RedWaltz-Moon/xiaoya-fpga-airwriting/技术复盘.md

# 空中书写学习系统：技术复盘

本文整理项目中可复用的设计经验与验证边界，状态截至2026年10月26日。部署、接线、编译和日常操作以各目录README为准。

## 文档分工

| 内容 | 入口 |
| --- | --- |
| 项目架构、目录与快速开始 | [项目README](README.md) |
| FPGA引脚、板端操作、灯环、音频、打印和时序限制 | [FPGA工程README](acg720_dvp_ov5640_hdmi/README.md) |
| 香橙派部署、课程、档案、小票与扩展协议 | [学习应用README](orange_pi_game/README.md) |
| 样本来源与划分 | [数据README](data/README.md) |
| 模型类型、训练方法与验证结果 | [模型README](models/README.md) |
| 采集、训练、推理与UART排错 | [工具README](tools/README.md) |

正式工程的顶层和输出基名均为 `acg720_dvp_ov5640_hdmi`。

## 系统分工的取舍

FPGA承担摄像头采集、目标检测、指尖与轨迹处理、64点重采样和串口传输；香橙派承担字符分类、学习交互、档案和小票排版。FPGA HDMI独立显示摄像头与调试画面，香橙派 HDMI显示学习应用。两端传递确认后的轨迹与字符事件，无需传输实时视频。

这一分工使视觉处理和学习界面可以分别排错。模型、词库或页面调整通常只影响香橙派；摄像头、检测与轨迹问题在FPGA端定位。当前模型是本地NumPy最近模板分类器，运行不以YOLO、神经网络或NPU部署为前提。

| 早期方案或现象 | 最终采用的方式 | 原因 |
| --- | --- | --- |
| 用整帧红色面积和总包围框判断目标 | 使用空间候选，分别检查面积、形状和位置关系 | 减少分散噪点或远处色块共同拉大检测框 |
| 将最高轮廓点直接当作指尖 | 在合格手部候选中结合单指形态与连续帧状态 | 张掌和握拳都可能出现局部突起，最高点不足以证明正在书写 |
| 直接将每次识别结果视作新的输入 | 一次确认轨迹对应一次应用字符事件 | 避免重复包、线程积压或长时间保持姿势造成重复计分 |
| 为相似大小写强行修改模型输出 | 保留62类预测，在应用判分层限定等价组 | 区分模型评估、FPGA回显与课程容错 |
| 由FPGA组织学习小票正文 | 香橙派完成记录选择、日期与GBK排版，FPGA转发 | FPGA无需理解课程、成绩或词汇内容 |

## FPGA视觉与轨迹处理

### 颜色入口与目标筛选

PEN使用红笔，HAND使用绿色手套；当前方案不要求背景布。光照、同色目标、轮廓完整度和摄像头极边缘漂白仍会影响检测，取消背景布条件并不意味着任意环境下都能稳定识别。

噪点问题不能只靠降低颜色门限解决。门限放宽会同时引入背景像素，形成桥接、拉长包围框，并影响位置估计。空间去噪、单候选面积和形态筛选应各自承担明确职责；显示mask中仍可能看到小噪点，但它们不应自动获得跟踪或书写资格。

HAND的8槽候选属于有限资源下的空间筛选，并非完整连通域合并。跟踪、断段和手势判定需要保留失配状态：短暂丢失时不能把不可信坐标接入轨迹，重新捕获也不能直接连向旧位置。单食指书写、比耶确认和五指张开清空是不同输入状态，不能用同一套最高点条件代替。

### 确认快照与状态边界

公共缓存最多保存256个采样点。确认后冻结当前轨迹，经有效性检查、等弧长64点重采样和保比例归一化，输出 `64×2 uint8` 坐标。确认、发送、等待回传和清空分别有明确的状态边界：

- 无效短轨迹不发送，也不产生假WAIT；确认后的缓存仍须清空才能重新书写。
- 有效轨迹整帧发完进入WAIT，合法同序号字符回传后进入DONE。
- 重复确认不能重新发送或擦掉已有结果；HAND确认后不能继续向已提交轨迹续画。
- 清空和模式切换同时处理当前轨迹与结果，不能只清显示层。

FPGA已经完成几何处理，软件再旋转、裁剪或重采样会改变模板比较的含义。采集、训练和在线推理应遵循同一坐标顺序与预处理约定。

### 存储、位宽与显示流水

历史移植中，点表写有RAM属性却仍可能被综合成寄存器和大型动态读选择器。应检查实际综合映射，而不只检查源码中的属性；同步RAM读延迟、单读口分拍及消隐期串行处理是控制资源和组合路径的常用方式。

计数器必须能表示终点，坐标缩放和地址运算必须保留足够的中间位宽。尤其要检查128、256等边界值、饱和处理和“先截断再移位”的表达式，避免出现只在大坐标或满缓存时暴露的错误。

视频像素、有效信号和行场计数需要同拍对齐。显示长路径可通过有效区预解码、窄位索引和查表分拍优化，但不能为消除报告违规而随意删除约束或添加假路径。

### 器件迁移与跨时钟域

ACG525/OV5647 MIPI与ACG720/OV5640 DVP属于不同链路，不能直接复用摄像头初始化表、行场假设或器件生成IP。138B参考工程中的PLL、DDR等生成结果也不能直接替代138C目标器件的IP。

摄像头处理、50MHz控制和HDMI像素输出处于不同时钟域。慢状态、单拍事件与多位快照需要分别使用同步器、翻转位或握手等相应机制；异步时钟分组只影响STA分析，不能替代RTL跨域正确性。复位释放同样需要结合各域时钟检查。

## 模型与课程判分

当前模板库来自同一书写者的930条PEN训练轨迹，另有独立场次310条验证轨迹。软件将64点坐标除以255、按原顺序展平为128维特征，以均方距离选择最近模板；每类负距离分数不是概率，也不能直接按“置信度0.8”解释。

B/D复核仅在基线输出大写B或D时，用8×8空间直方图在两者之间重选。它是推理开关，不会因为NPZ文件名包含 `bdshape` 就自动生效；游戏正式入口开启该策略，独立推理需显式指定。验证集已参与选型，不能将该成绩视作未见最终测试、跨人或HAND专门测试的准确率。

PEN与HAND在串口上提供同一种轨迹格式，应用不需要为两种输入切换页面或模型。共用模型不代表训练来源相同，运行日志中的输入方式也不能仅凭NPZ来源推断。

课程只对 `C/c、S/s、O/o、Z/z` 四组进行大小写容错；其他字符关系仍需严格区分，`0/O`不属于等价组。判分容错不改写模型预测、串口回显或原始分数，应用通过率与严格62类准确率应分别统计。

现有6089词题库按词长控制书写量：数字课10题，单词课总字母数不超过20，混写总字符数不超过20。完整单词参与选题而非截断拼接；长词逐步加入。词库扩充只增加学习内容，不增加模型类别；中文释义和中文小票也不代表支持中文手写识别。

## 串口、应用事件与打印

### 帧序号与应用事件

主机连接保持115200 / 8N1。V1轨迹上行138字节、字符结果下行11字节，均校验CRC16并匹配序号。8位 `seq` 会回绕，FPGA复位后也会归零，因此它不是累计样本数或全局事件编号。

应用桥单独分配事件号，并处理连续相同帧、断线重连和过期队列。该机制减少重复输入，但V1没有ACK、复位通知或完整会话标识，不能完全区分快速复位后内容相同的新笔迹与迟到旧包。串口写入成功、事件入队和游戏消费也是不同阶段，日志应保留各阶段状态。

### 打印链路

香橙派选择黑板文本或一条课程记录，完成日期、成绩、练习与错题摘要的GBK排版；FPGA校验并缓存载荷，再从独立9600 / 8N1串口向E10发送。打印任务使用独立32位 `job_id`，不把轨迹 `seq` 当作打印任务编号。

单票上限按GBK字节数计算，不能直接按字符数判断。中文、换行和标题均计入512字节；排版还要满足32西文列或16汉字的行宽。E10实物的行序补偿只作用于最终打印数据，不应倒置档案或界面预览。

当前配置下，香橙派应用、FPGA与E10的GBK完整链路已通过实机测试，行序补偿后打印正常。

`SENT`只说明FPGA打印UART最后停止位发送结束。打印机TX及BUSY未接入，系统没有缺纸或实际出纸完成反馈；超时后自动补发可能产生重复小票。正文变成十六进制时，应优先核对打印机是否停在自检后的DUMP模式。

灯环和打印机均使用开发板5V电源接口，并与FPGA共地；GPIO0 BANK保持3.3V。电源接口与GPIO数据信号是不同连接，具体接线见FPGA工程README。

## 验证结果的解释

现有系统已完成PEN/HAND、香橙派学习应用、收发回显、周边、打印与灯环等功能。当前16灯WS2812B状态灯环已通过实机功能测试。

保留的工程边界如下：

- **真实PCLK时序尚未签核。** 历史计频约87.5MHz，正式SDC仍约束为50MHz；现有约束下Setup/Hold零违规不能证明实际频率闭合。PR1014通用时钟路由提示仍需结合真实时钟评估。
- **HDMI偶发无信号未确定根因。** 曾怀疑连接问题，不能据此写成已定位或已修复；应区分输出链路异常与其他外设仍正常的情况。
- **自检覆盖有限。** DDR为16KiB两轮局部写读，HDMI内部扫描正常也不证明显示器已经连接，不能把检查页等同于完整硬件可靠性测试。
- **识别泛化有限。** 模板受笔顺、字形与噪声影响，未提供跨书写者、独立HAND最终测试或通用未知字符拒识的结论。
- **极端生命周期仍有边界。** 极快清空再确认的旧帧关联、复位后的相同帧以及打印超时后的实际状态，不能由普通逐字使用测试完全覆盖。

这些边界用于准确描述现有成果。

## 许可证

本文随项目自研文档采用 [MIT License](LICENSE)，署名RedWaltz。第三方IP、参考代码、词库和依赖仍遵循各自许可，范围见项目README。
