RedWaltz-Moon/xiaoya-fpga-airwriting/acg720_dvp_ov5640_hdmi/impl/gwsynthesis/acg720_dvp_ov5640_hdmi_syn_resource.html

# Hierarchy Module Resource

MODULE NAME | REG NUMBER | ALU NUMBER | LUT NUMBER | DSP NUMBER | BSRAM NUMBER | SSRAM NUMBER | ROM16 NUMBER
acg720_dvp_ov5640_hdmi (D:/Gowin_FPGA/Gowin/Gowin_V1.9.12_x64/Object/acg720_dvp_ov5640_hdmi/src/acg720_dvp_ov5640_hdmi.v) | 127 | 27 | 344 | - | - | - | -
|--u_elapsed_time_sevenseg (D:/Gowin_FPGA/Gowin/Gowin_V1.9.12_x64/Object/acg720_dvp_ov5640_hdmi/src/acg720_dvp_ov5640_hdmi.v) | 98 | - | 169 | - | - | - | -
|--u_key_s1_mode (D:/Gowin_FPGA/Gowin/Gowin_V1.9.12_x64/Object/acg720_dvp_ov5640_hdmi/src/acg720_dvp_ov5640_hdmi.v) | 24 | - | 40 | - | - | - | -
|--u_key_s2_view (D:/Gowin_FPGA/Gowin/Gowin_V1.9.12_x64/Object/acg720_dvp_ov5640_hdmi/src/acg720_dvp_ov5640_hdmi.v) | 24 | - | 39 | - | - | - | -
|--u_key_s3_action (D:/Gowin_FPGA/Gowin/Gowin_V1.9.12_x64/Object/acg720_dvp_ov5640_hdmi/src/acg720_dvp_ov5640_hdmi.v) | 24 | - | 39 | - | - | - | -
|--u_key_s4_action (D:/Gowin_FPGA/Gowin/Gowin_V1.9.12_x64/Object/acg720_dvp_ov5640_hdmi/src/acg720_dvp_ov5640_hdmi.v) | 24 | - | 39 | - | - | - | -
|--u_ht6221_remote_buttons (D:/Gowin_FPGA/Gowin/Gowin_V1.9.12_x64/Object/acg720_dvp_ov5640_hdmi/src/acg720_dvp_ov5640_hdmi.v) | 93 | 8 | 199 | - | - | - | -
|--u_ddr_pll (D:/Gowin_FPGA/Gowin/Gowin_V1.9.12_x64/Object/acg720_dvp_ov5640_hdmi/src/acg720_dvp_ov5640_hdmi.v) | - | - | - | - | - | - | -
|--u_pll (D:/Gowin_FPGA/Gowin/Gowin_V1.9.12_x64/Object/acg720_dvp_ov5640_hdmi/src/gowin_pll/gowin_pll.v) | - | - | - | - | - | - | -
|--u_pll_init (D:/Gowin_FPGA/Gowin/Gowin_V1.9.12_x64/Object/acg720_dvp_ov5640_hdmi/src/gowin_pll/gowin_pll.v) | 37 | 16 | 55 | - | - | - | -
|--u_startup_ddr_test (D:/Gowin_FPGA/Gowin/Gowin_V1.9.12_x64/Object/acg720_dvp_ov5640_hdmi/src/acg720_dvp_ov5640_hdmi.v) | 69 | - | 303 | - | - | - | -
|--u_ddr3 (D:/Gowin_FPGA/Gowin/Gowin_V1.9.12_x64/Object/acg720_dvp_ov5640_hdmi/src/acg720_dvp_ov5640_hdmi.v) | 3406 | 125 | 2147 | - | 8 | - | -
|--u_camera_init (D:/Gowin_FPGA/Gowin/Gowin_V1.9.12_x64/Object/acg720_dvp_ov5640_hdmi/src/acg720_dvp_ov5640_hdmi.v) | 34 | - | 74 | - | - | - | -
|--ov5640_init_table_rgb_inst (D:/Gowin_FPGA/Gowin/Gowin_V1.9.12_x64/Object/acg720_dvp_ov5640_hdmi/src/camera/camera_init.v) | - | - | - | - | 1 | - | -
|--i2c_control (D:/Gowin_FPGA/Gowin/Gowin_V1.9.12_x64/Object/acg720_dvp_ov5640_hdmi/src/camera/camera_init.v) | 44 | - | 115 | - | - | - | -
|--i2c_bit_shift (D:/Gowin_FPGA/Gowin/Gowin_V1.9.12_x64/Object/acg720_dvp_ov5640_hdmi/src/camera/i2c_control/i2c_control.v) | 23 | - | 79 | - | - | - | -
|--u_dvp_capture (D:/Gowin_FPGA/Gowin/Gowin_V1.9.12_x64/Object/acg720_dvp_ov5640_hdmi/src/acg720_dvp_ov5640_hdmi.v) | 56 | - | 47 | - | - | - | -
|--u_red_pen_centroid (D:/Gowin_FPGA/Gowin/Gowin_V1.9.12_x64/Object/acg720_dvp_ov5640_hdmi/src/acg720_dvp_ov5640_hdmi.v) | 1128 | 957 | 2291 | 1 | - | - | -
|--u_mask_line_buffer (D:/Gowin_FPGA/Gowin/Gowin_V1.9.12_x64/Object/acg720_dvp_ov5640_hdmi/src/vision/red_pen_centroid.v) | - | - | - | - | 1 | - | -
|--u_trajectory_bitmap (D:/Gowin_FPGA/Gowin/Gowin_V1.9.12_x64/Object/acg720_dvp_ov5640_hdmi/src/vision/red_pen_centroid.v) | - | - | - | - | 1 | - | -
|--u_hand_skin_mask (D:/Gowin_FPGA/Gowin/Gowin_V1.9.12_x64/Object/acg720_dvp_ov5640_hdmi/src/acg720_dvp_ov5640_hdmi.v) | 1577 | 1443 | 2797 | - | - | - | -
|--u_hand_mask_line_buffer (D:/Gowin_FPGA/Gowin/Gowin_V1.9.12_x64/Object/acg720_dvp_ov5640_hdmi/src/vision/hand_skin_mask.v) | - | - | - | - | 1 | - | -
|--u_hand_trajectory_bitmap (D:/Gowin_FPGA/Gowin/Gowin_V1.9.12_x64/Object/acg720_dvp_ov5640_hdmi/src/vision/hand_skin_mask.v) | - | - | - | - | 1 | - | -
|--u_trajectory_point_buffer (D:/Gowin_FPGA/Gowin/Gowin_V1.9.12_x64/Object/acg720_dvp_ov5640_hdmi/src/acg720_dvp_ov5640_hdmi.v) | 20 | - | 29 | - | 1 | - | -
|--u_trajectory_resampler (D:/Gowin_FPGA/Gowin/Gowin_V1.9.12_x64/Object/acg720_dvp_ov5640_hdmi/src/acg720_dvp_ov5640_hdmi.v) | 421 | 485 | 458 | 6 | 1 | - | -
|--u_divider (D:/Gowin_FPGA/Gowin/Gowin_V1.9.12_x64/Object/acg720_dvp_ov5640_hdmi/src/trajectory/trajectory_resampler.v) | 153 | 43 | 126 | - | - | - | -
|--u_host_uart_bridge (D:/Gowin_FPGA/Gowin/Gowin_V1.9.12_x64/Object/acg720_dvp_ov5640_hdmi/src/acg720_dvp_ov5640_hdmi.v) | 62 | - | 5 | - | - | - | -
|--u_rx (D:/Gowin_FPGA/Gowin/Gowin_V1.9.12_x64/Object/acg720_dvp_ov5640_hdmi/src/uart/host_uart_bridge.v) | 41 | - | 50 | - | - | - | -
|--u_print (D:/Gowin_FPGA/Gowin/Gowin_V1.9.12_x64/Object/acg720_dvp_ov5640_hdmi/src/uart/host_uart_bridge.v) | 337 | 71 | 354 | - | 1 | - | -
|--u_printer (D:/Gowin_FPGA/Gowin/Gowin_V1.9.12_x64/Object/acg720_dvp_ov5640_hdmi/src/uart/host_uart_bridge.v) | 32 | - | 49 | - | - | - | -
|--u_status (D:/Gowin_FPGA/Gowin/Gowin_V1.9.12_x64/Object/acg720_dvp_ov5640_hdmi/src/uart/host_uart_bridge.v) | 91 | - | 103 | - | - | - | -
|--u_tx (D:/Gowin_FPGA/Gowin/Gowin_V1.9.12_x64/Object/acg720_dvp_ov5640_hdmi/src/uart/print_status_tx.v) | 32 | - | 50 | - | - | - | -
|--u_trajectory_uart_packet_tx (D:/Gowin_FPGA/Gowin/Gowin_V1.9.12_x64/Object/acg720_dvp_ov5640_hdmi/src/acg720_dvp_ov5640_hdmi.v) | 68 | 7 | 220 | - | - | - | -
|--u_uart_tx (D:/Gowin_FPGA/Gowin/Gowin_V1.9.12_x64/Object/acg720_dvp_ov5640_hdmi/src/uart/trajectory_uart_packet_tx.v) | 32 | - | 51 | - | - | - | -
|--u_result_uart_packet_rx (D:/Gowin_FPGA/Gowin/Gowin_V1.9.12_x64/Object/acg720_dvp_ov5640_hdmi/src/acg720_dvp_ov5640_hdmi.v) | 19 | 8 | 9 | - | - | - | -
|--u_ws2812_status_ring (D:/Gowin_FPGA/Gowin/Gowin_V1.9.12_x64/Object/acg720_dvp_ov5640_hdmi/src/acg720_dvp_ov5640_hdmi.v) | 56 | 13 | 83 | - | - | - | -
|--u_ws2812b_tx (D:/Gowin_FPGA/Gowin/Gowin_V1.9.12_x64/Object/acg720_dvp_ov5640_hdmi/src/display/ws2812_status_ring.v) | 57 | - | 101 | - | - | - | -
|--u_ssd1306_status_i2c (D:/Gowin_FPGA/Gowin/Gowin_V1.9.12_x64/Object/acg720_dvp_ov5640_hdmi/src/acg720_dvp_ov5640_hdmi.v) | 90 | 4 | 408 | - | 2 | - | -
|--u_oled_i2c_tx (D:/Gowin_FPGA/Gowin/Gowin_V1.9.12_x64/Object/acg720_dvp_ov5640_hdmi/src/display/ssd1306_status_i2c.v) | 35 | - | 58 | - | - | - | -
|--u_hdmi_pll (D:/Gowin_FPGA/Gowin/Gowin_V1.9.12_x64/Object/acg720_dvp_ov5640_hdmi/src/acg720_dvp_ov5640_hdmi.v) | - | - | - | - | - | - | -
|--u_pll (D:/Gowin_FPGA/Gowin/Gowin_V1.9.12_x64/Object/acg720_dvp_ov5640_hdmi/src/hdmi_pll/hdmi_pll.v) | - | - | - | - | - | - | -
|--u_pll_init (D:/Gowin_FPGA/Gowin/Gowin_V1.9.12_x64/Object/acg720_dvp_ov5640_hdmi/src/hdmi_pll/hdmi_pll.v) | 39 | 16 | 55 | - | - | - | -
|--u_ddr3_frame_buffer (D:/Gowin_FPGA/Gowin/Gowin_V1.9.12_x64/Object/acg720_dvp_ov5640_hdmi/src/acg720_dvp_ov5640_hdmi.v) | 77 | 9 | 174 | - | - | - | -
|--u_wr_data_fifo (D:/Gowin_FPGA/Gowin/Gowin_V1.9.12_x64/Object/acg720_dvp_ov5640_hdmi/src/ddr3_frame_buffer.v) | 79 | 9 | 72 | - | 4 | - | -
|--u_rd_data_fifo (D:/Gowin_FPGA/Gowin/Gowin_V1.9.12_x64/Object/acg720_dvp_ov5640_hdmi/src/ddr3_frame_buffer.v) | 88 | 18 | 257 | - | 4 | - | -
|--u_video_720p_camera (D:/Gowin_FPGA/Gowin/Gowin_V1.9.12_x64/Object/acg720_dvp_ov5640_hdmi/src/acg720_dvp_ov5640_hdmi.v) | 249 | 13 | 386 | 1 | 1 | - | -
|--u_engineering_hud (D:/Gowin_FPGA/Gowin/Gowin_V1.9.12_x64/Object/acg720_dvp_ov5640_hdmi/src/video_720p_camera.v) | - | 9 | 16 | - | - | - | -
|--u_board_health_monitor (D:/Gowin_FPGA/Gowin/Gowin_V1.9.12_x64/Object/acg720_dvp_ov5640_hdmi/src/acg720_dvp_ov5640_hdmi.v) | 93 | - | 102 | - | - | - | -
|--u_result_audio_event (D:/Gowin_FPGA/Gowin/Gowin_V1.9.12_x64/Object/acg720_dvp_ov5640_hdmi/src/acg720_dvp_ov5640_hdmi.v) | 16 | - | 15 | - | - | - | -
|--u_meow_pcm_player (D:/Gowin_FPGA/Gowin/Gowin_V1.9.12_x64/Object/acg720_dvp_ov5640_hdmi/src/acg720_dvp_ov5640_hdmi.v) | 47 | - | 75 | - | 8 | - | -
|--u_hdmi_tmds_tx (D:/Gowin_FPGA/Gowin/Gowin_V1.9.12_x64/Object/acg720_dvp_ov5640_hdmi/src/acg720_dvp_ov5640_hdmi.v) | 39 | - | 73 | - | - | 9 | -
|--u_hdmi_audio_island (D:/Gowin_FPGA/Gowin/Gowin_V1.9.12_x64/Object/acg720_dvp_ov5640_hdmi/src/hdmi_tmds_tx.v) | 188 | - | 509 | - | - | 16 | -
|--u_encode_blue (D:/Gowin_FPGA/Gowin/Gowin_V1.9.12_x64/Object/acg720_dvp_ov5640_hdmi/src/hdmi_tmds_tx.v) | 48 | 52 | 64 | - | - | - | -
|--u_encode_green (D:/Gowin_FPGA/Gowin/Gowin_V1.9.12_x64/Object/acg720_dvp_ov5640_hdmi/src/hdmi_tmds_tx.v) | 43 | 49 | 72 | - | - | - | -
|--u_encode_red (D:/Gowin_FPGA/Gowin/Gowin_V1.9.12_x64/Object/acg720_dvp_ov5640_hdmi/src/hdmi_tmds_tx.v) | 40 | 52 | 64 | - | - | - | -
|--u_serializer (D:/Gowin_FPGA/Gowin/Gowin_V1.9.12_x64/Object/acg720_dvp_ov5640_hdmi/src/hdmi_tmds_tx.v) | - | - | - | - | - | - | -
