RedWaltz-Moon/xiaoya-fpga-airwriting/3D外壳/笔/上半.SLDPRT

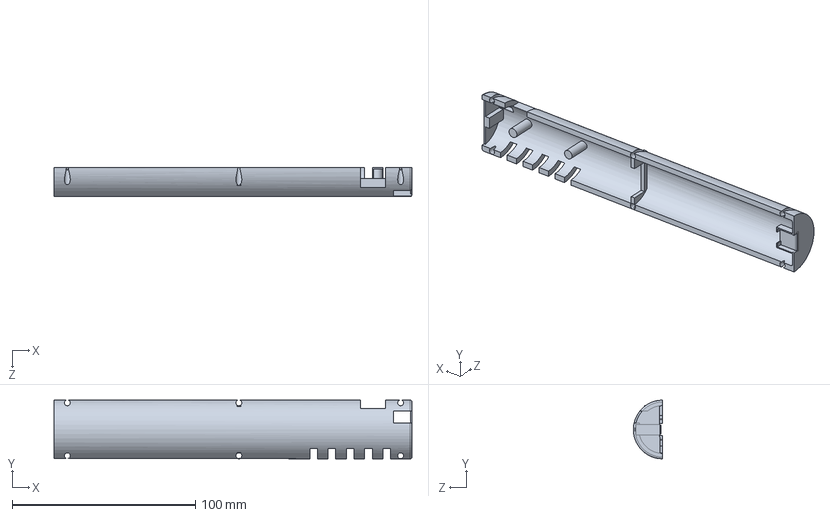
[picture p1: CAD file, 2026-10-30]
3D外壳/笔/上半.SLDPRT
195.5 x 32.1 x 16.0 mm
