RedWaltz-Moon/xiaoya-fpga-airwriting/3D外壳/箱体/06_侧板B.SLDPRT

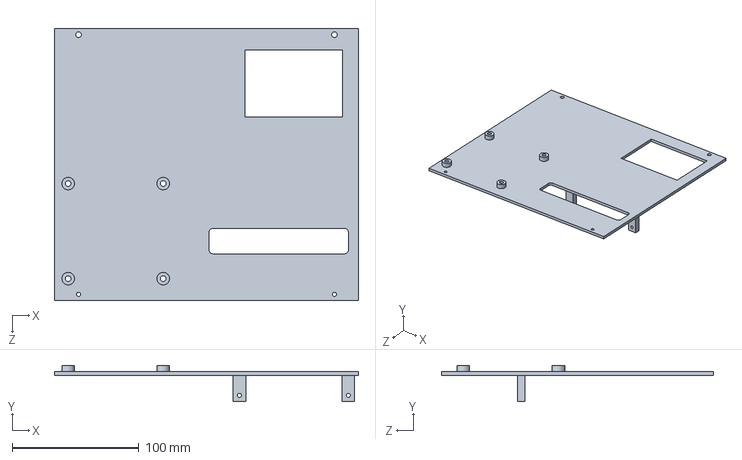
[picture p2: CAD file, 2026-10-30]
3D外壳/箱体/06_侧板B.SLDPRT
240.0 x 28.7 x 215.0 mm
