RedWaltz-Moon/xiaoya-fpga-airwriting/3D外壳/笔/下半.SLDPRT

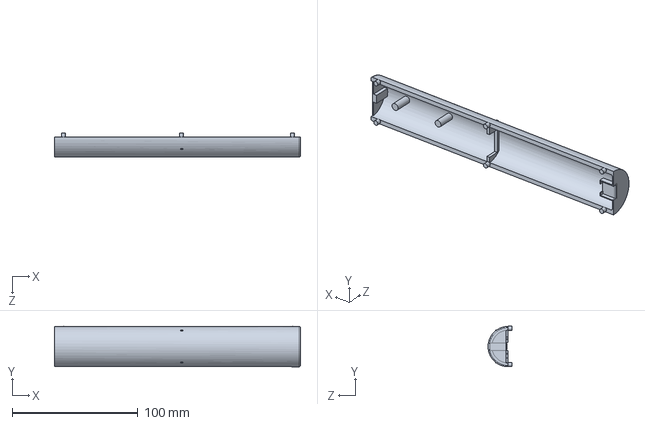
[picture p3: CAD file, 2026-10-30]
3D外壳/笔/下半.SLDPRT
195.5 x 32.2 x 19.0 mm
