RedWaltz-Moon/xiaoya-fpga-airwriting/3D外壳/箱体/07_内部隔板.SLDPRT

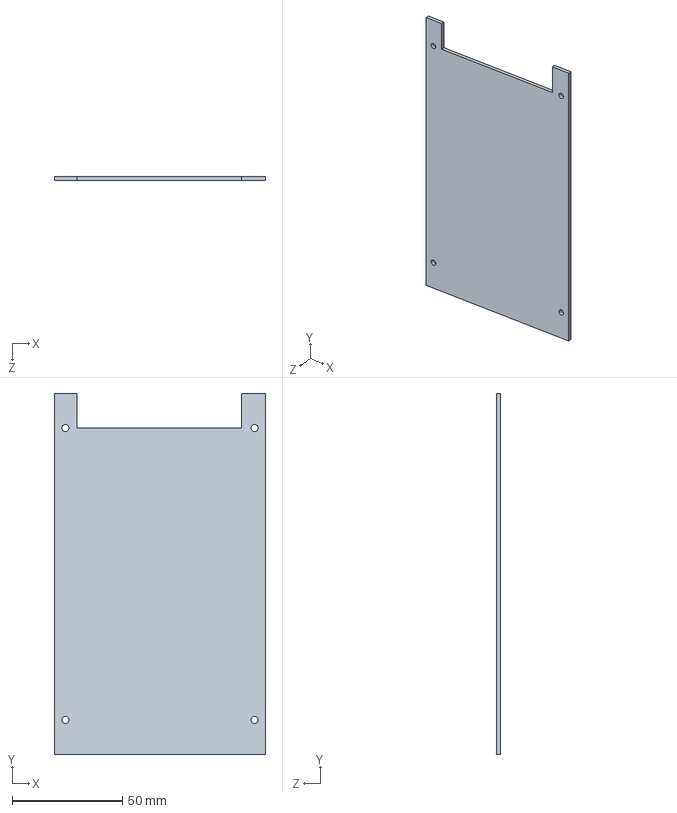
[picture p4: CAD file, 2026-10-30]
3D外壳/箱体/07_内部隔板.SLDPRT
96.0 x 164.0 x 2.00 mm
