RedWaltz-Moon/xiaoya-fpga-airwriting/3D外壳/箱体/02_顶盖.SLDPRT

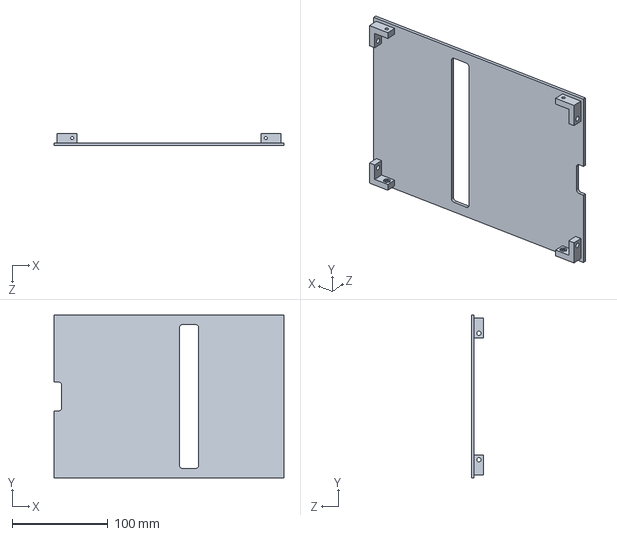
[picture p5: CAD file, 2026-10-30]
3D外壳/箱体/02_顶盖.SLDPRT
240.0 x 170.0 x 13.0 mm
