RedWaltz-Moon/xiaoya-fpga-airwriting/3D外壳/箱体/04_端板B.SLDPRT

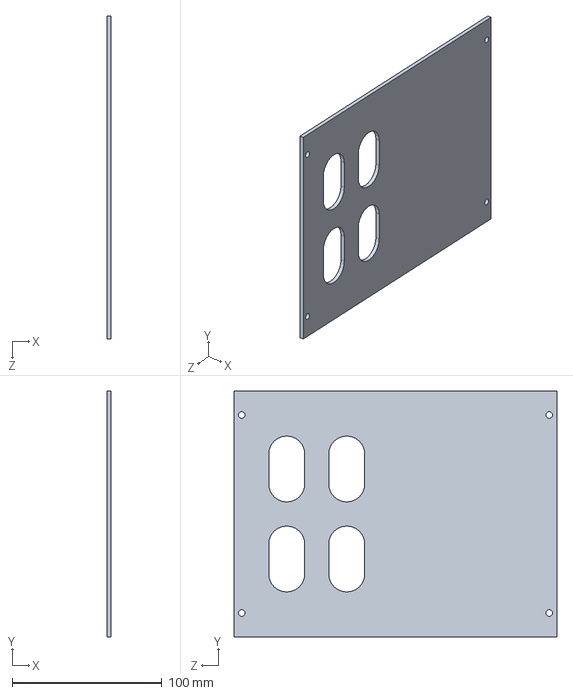
[picture p6: CAD file, 2026-10-30]
3D外壳/箱体/04_端板B.SLDPRT
3.00 x 164.0 x 215.0 mm
