RedWaltz-Moon/xiaoya-fpga-airwriting/3D外壳/箱体/01_底板.SLDPRT

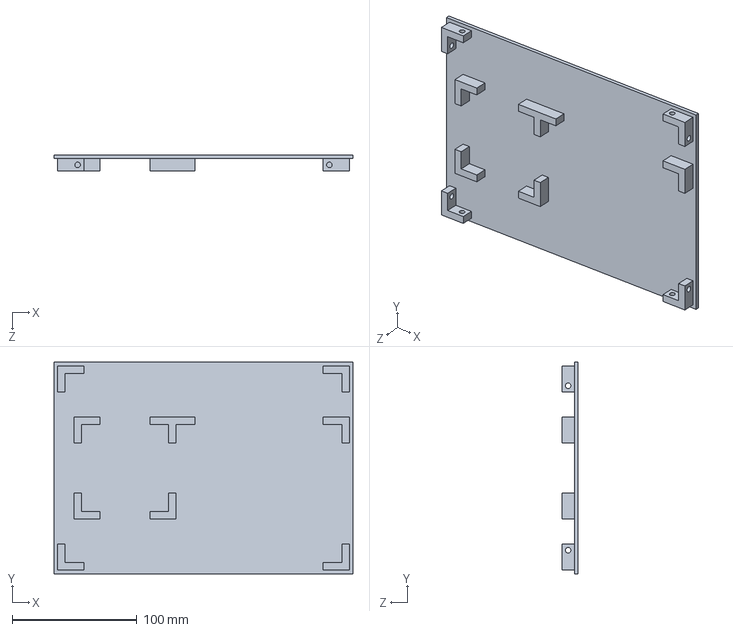
[picture p7: CAD file, 2026-10-30]
3D外壳/箱体/01_底板.SLDPRT
240.0 x 170.0 x 13.0 mm
