RedWaltz-Moon/xiaoya-fpga-airwriting/3D外壳/箱体/05_侧板A.SLDPRT

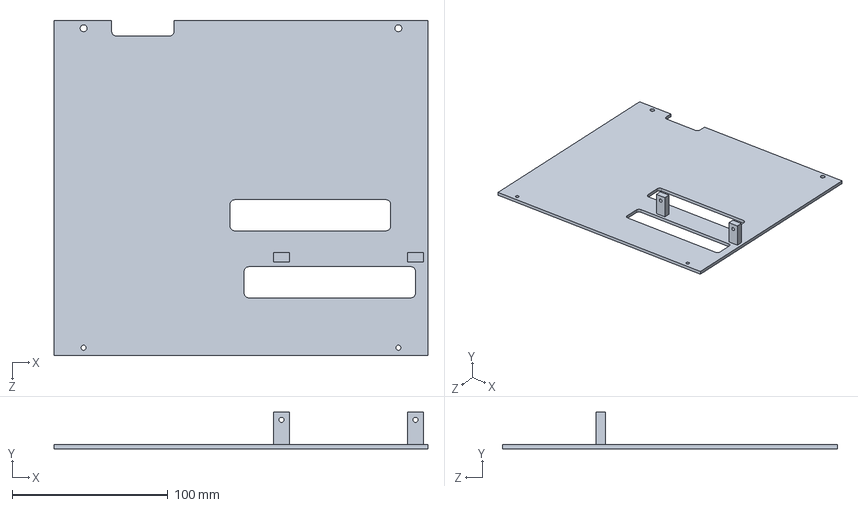
[picture p8: CAD file, 2026-10-30]
3D外壳/箱体/05_侧板A.SLDPRT
240.0 x 23.7 x 215.0 mm
