RedWaltz-Moon/xiaoya-fpga-airwriting/3D外壳/箱体/03_端板A.SLDPRT

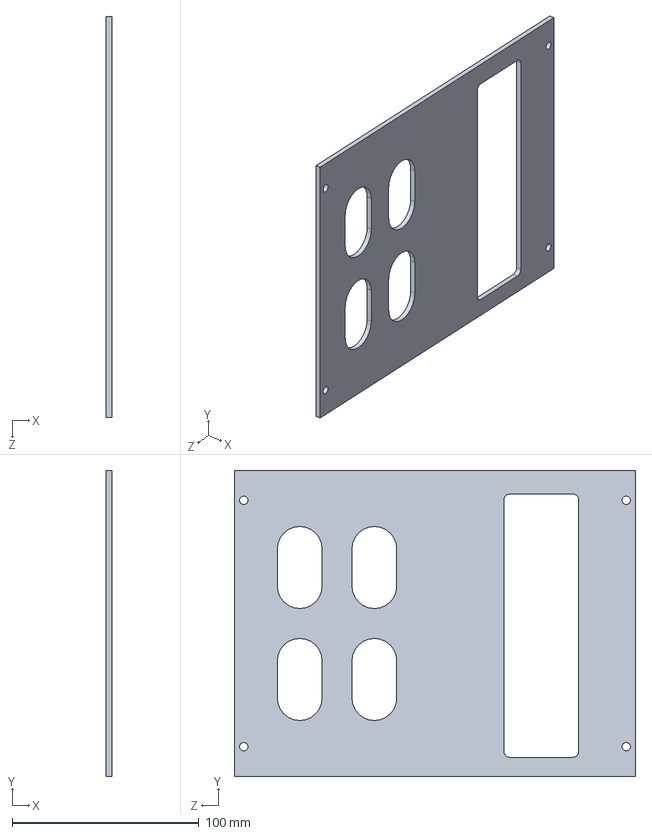
[picture p9: CAD file, 2026-10-30]
3D外壳/箱体/03_端板A.SLDPRT
3.00 x 164.0 x 215.0 mm
