RedWaltz-Moon/xiaoya-fpga-airwriting/acg720_dvp_ov5640_hdmi/src/control/board_health_monitor.v

`timescale 1ns / 1ps

// M7B只读健康监测：50 MHz参考域统计摄像头VS帧数、汇总开机检查。
// 本模块不复位外设、不发送串口数据，也不向图像管线提供反压。
// check位：0时钟锁定、1DDR校准、2DDR写读比较、3相机初始化、
// 4相机有效视频、5HDMI内部扫描、6OLED应答、7有效UART回传。
// UART需要外部主机/真实书写验证，不作为开机必过项；HDMI项不证明屏幕已连接。
module board_health_monitor #(
    parameter [25:0] SECOND_LAST = 26'd49_999_999,
    parameter [3:0] BOOT_SECONDS = 4'd8,
    parameter [3:0] SHOW_SECONDS = 4'd10
) (
    input wire clk,
    input wire reset_n,
    input wire camera_clk,
    input wire camera_reset_n,
    input wire camera_vs,
    input wire hdmi_clk,
    input wire hdmi_reset_n,
    input wire hdmi_vs,
    input wire ddr_pll_locked,
    input wire hdmi_pll_locked,
    input wire ddr_calibrated,
    input wire ddr_test_pass,
    input wire ddr_test_failed,
    input wire camera_initialized,
    input wire camera_pixels_seen,
    input wire frame_ready,
    input wire buffer_fault,
    input wire oled_initialized,
    input wire oled_ack_seen,
    input wire oled_ack_error,
    input wire result_valid,
    // 多位状态通过保持数据+请求/应答翻转位传给HDMI，禁止裸同步BCD数位。
    input wire display_ack_async,
    output reg [27:0] display_payload,
    output reg display_request,
    output wire [1:0] boot_state,
    output wire [7:0] check_pass,
    output reg [7:0] check_fail
);
    reg camera_vs_d;
    reg camera_frame_toggle;
    always @(posedge camera_clk or negedge camera_reset_n) begin
        if (!camera_reset_n) begin
            camera_vs_d <= 1'b0;
            camera_frame_toggle <= 1'b0;
        end else begin
            camera_vs_d <= camera_vs;
            if (camera_vs && !camera_vs_d)
                camera_frame_toggle <= ~camera_frame_toggle;
        end
    end

    reg hdmi_vs_d;
    reg hdmi_frame_toggle;
    always @(posedge hdmi_clk or negedge hdmi_reset_n) begin
        if (!hdmi_reset_n) begin
            hdmi_vs_d <= 1'b0;
            hdmi_frame_toggle <= 1'b0;
        end else begin
            hdmi_vs_d <= hdmi_vs;
            if (hdmi_vs && !hdmi_vs_d)
                hdmi_frame_toggle <= ~hdmi_frame_toggle;
        end
    end
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
