RedWaltz-Moon/xiaoya-fpga-airwriting/(commit log)

2026-10-29 Publish complete FPGA project with Git LFS
    [device.cfg]
2026-10-30 Add red pen source archive and enclosure CAD files
    [01_底板.SLDPRT, 02_顶盖.SLDPRT, 03_端板A.SLDPRT, 04_端板B.SLDPRT, 05_侧板A.SLDPRT, 06_侧板B.SLDPRT, 07_内部隔板.SLDPRT, 上半.SLDPRT]
